makersmakingchange/LipSync-Wireless/README.md

## LipSync Wireless
**As of 2024-Feb-08, this version of the LipSync is now obsolete and has been replaced by the [LipSync 4](https://github.com/makersmakingchange/LipSync).**

<p align="center">
LipSync Logo
</p>

The LipSync is an assistive technology device that allows quadriplegics and other people with limited hand function to use touchscreen mobile devices, tablets, and computers by manipulation of a mouth-operated joystick with integrated sip and puff controls. This is an Open-Source Hardware project, so the Lipsync can be made at the community level for less than $300.

This GitHub repository will serve as a database for all files and documentation associated with the LipSync Wireless project.

WARNING - Unfortunately, as of 2021-Jul-21, the Bluetooth Module has been retired and is no longer for sale [Sparkfun Bluetooth Mate Silver](https://www.sparkfun.com/products/retired/12576). There is no suitable replacement component at this time. An updated design based on new hardware is under development ([LipSync X](https://github.com/makersmakingchange/LipSyncX)) but is not ready for release yet.

## Compatibility 

 <table style="width:100%">
  <tr>
    <th>Operating Systems</th>
    <th>Version</th>
    <th>Release</th>
    <th>Additional Information</th>
  <tr>
    <td>iOS</td>
    <td>13.1</td>
    <td>September 19,2019</td>
    <td>Compatible with iPhone 7 and newer versions</td>
  </tr>
  <tr>
    <td>Windows</td>
    <td>7-10</td>
    <td>2009</td>
    <td>Compatible with Windows 7 and newer versions (Requires Bluetooth 2.0 receiver)</td>
  </tr>
  <tr>
    <td>Android</td>
    <td>4+</td>
    <td>Released 2013</td>
    <td>Compatible with Android 4 and newer versions (Requires Bluetooth 2.0 receiver)</td>
  </tr>
  <tr>
    <td>MacOS</td>
    <td>10</td>
    <td>Released 2000</td>
    <td>Compatible with Mac OS X 10.0 and newer versions (Requires Bluetooth 2.0 receiver)</td>
  </tr>
  </table> 
  
## Getting Started
There are several options for obtaining a LipSync Wireless device.
1. Build it yourself
2. Request a volunteer maker to build one for you.

### 1. Build it Yourself
All the information you need to build a LipSync Wireless is avaiable in this repository. You'll need to order a number of off-the-shelf components, order a set of custom printed circuit boards and 3D print a number of components.

### 2. Volunteer Build
You can submit a build request through the Makers Making Change Website. A volunteer maker will build a LipSync and the requestor is responsible for the cost of materials and any shipping.

First, you'll need to [sign up](https://www.makersmakingchange.com/sign-up/) to create an account. Once your account is activated, you can log in.

Second, [submit a build request](https://makersmakingchange.com/request-a-build?project_id=3905) for a LipSync.

Once a volunteer maker agrees to take on your request, communicate with them to discuss details and reimbursement.

## Download

 <table style="width:100%">
  <tr>
    <th>Resource</th>
    <th>Version</th>
    <th>Format</th>
    <th>Link</th>
  </tr>
  <tr>
    <td>LipSync Wireless All</td>
    <td>3.0</td>
    <td>ZIP</td>
    <td><a href="https://github.com/makersmakingchange/LipSync-Wireless/archive/refs/heads/master.zip">LipSync-Wireless.zip</a></td>
  </tr>
  <tr>
    <td>LipSync Wireless Assembly Guide</td>
    <td>1.6</td>
    <td>PDF</td>
    <td><a href="https://github.com/makersmakingchange/LipSync-Wireless/blob/master/Documentation/LipSync_Assembly_Guide.pdf">LipSync_Assembly_Guide.pdf</a></td>
  </tr>
  <tr>
    <td>LipSync Wireless Startup Guide</td>
    <td>1.3</td>
    <td>PDF</td>
    <td><a href="https://github.com/makersmakingchange/LipSync-Wireless/blob/master/Documentation/LipSync_Wireless_Startup_Guide.pdf">LipSync_Wireless_Startup_Guide.pdf</a></td>
  </tr>
  <tr>
    <td>LipSync Wireless User Guide</td>
    <td>1.3</td>
    <td>PDF</td>
    <td><a href="https://github.com/makersmakingchange/LipSync-Wireless/blob/master/Documentation/LipSync_Wireless_User_Guide.pdf">LipSync_Wireless_User_Guide.pdf</a></td>
  </tr>
  <tr>
     <td>LipSync Wireless Mounting Guide</td>
     <td>1.0</td>
     <td>PDF</td>
     <td><a href="https://github.com/makersmakingchange/LipSync-Wireless/blob/master/Documentation/LipSync_Mounting_Guide.pdf">LipSync_Mounting_Guide.pdf</a></td>
  </tr>
  <tr>
    <td>LipSync Wireless BOM (XLSX)</td>
    <td>September 1, 2021</td>
    <td>XLSX</td>
    <td><a href="https://github.com/makersmakingchange/LipSync-Wireless/blob/master/Documentation/LipSync_Wireless_BOM.xlsx">LipSync_Wireless_BOM.xlsx</a></td>
  </tr>
  <tr>
    <td>LipSync Wireless BOM (CSV)</td>
    <td>September 1, 2021</td>
    <td>CSV</td>
    <td><a href="https://github.com/makersmakingchange/LipSync-Wireless/blob/master/Documentation/LipSync_Wireless_BOM.csv" download target="_blank">LipSync_Wireless_BOM.csv</a></td>
  </tr>
  <tr>
    <td>LipSync Wireless Firmware</td>
    <td>3.0</td>
    <td>INO</td>
    <td><a href="https://raw.githubusercontent.com/makersmakingchange/LipSync-Wireless/master/Software/LipSync_Wireless_Firmware/LipSync_Wireless_Firmware.ino">LipSync_Wireless_Firmware.ino</a></td>
  </tr>
  <tr>
    <td>Interface Board Layout</td>
    <td>2.71</td>
    <td>BRD</td>
    <td><a href="https://raw.githubusercontent.com/makersmakingchange/LipSync-Wireless/master/Hardware/PCB_design/Eagle/LipSync_Interface_Board/LipSync_Interface_Board.brd">LipSync_Interface_Board.brd</a></td>
  </tr>
  <tr>
    <td>Interface Board Schematic</td>
    <td>2.71</td>
    <td>SCH</td>
    <td><a href="https://raw.githubusercontent.com/makersmakingchange/LipSync-Wireless/master/Hardware/PCB_design/Eagle/LipSync_Interface_Board/LipSync_Interface_Board.sch">LipSync_Interface_Board.sch</a></td>
  </tr>
  <tr>
    <td>JLCPCB LipSync Interface Board Gerber</td>
    <td>2.71</td>
    <td>ZIP</td>
    <td><a href="https://github.com/makersmakingchange/LipSync-Wireless/raw/master/Hardware/PCB_design/Gerber/LipSync_Interface_Board/JLCPCB_LipSync_Interface_Board.zip">JLCPCB_LipSync_Interface_Board.zip</a></td>
  </tr>
  <tr>
    <td>OSHPark LipSync Interface Board Gerber</td>
    <td>2.71</td>
    <td>ZIP</td>
    <td><a href="https://github.com/makersmakingchange/LipSync-Wireless/raw/master/Hardware/PCB_design/Gerber/LipSync_Interface_Board/OSHPark_LipSync_Interface_Board.zip">OSHPark_LipSync_Interface_Board.zip</a></td>
  </tr>
  <tr>
    <td>PCBWay LipSync Interface Board Gerber</td>
    <td>2.71</td>
    <td>ZIP</td>
    <td><a href="https://github.com/makersmakingchange/LipSync-Wireless/raw/master/Hardware/PCB_design/Gerber/LipSync_Interface_Board/PCBWay_LipSync_Interface_Board.zip">PCBWay_LipSync_Interface_Board.zip</a></td>
  </tr>
  <tr>
    <td>Seeed Fusion LipSync Interface Board Gerber</td>
    <td>2.71</td>
    <td>ZIP</td>
    <td><a href="https://github.com/makersmakingchange/LipSync-Wireless/raw/master/Hardware/PCB_design/Gerber/LipSync_Interface_Board/Seeed_Fusion_LipSync_Interface_Board.zip">Seeed_Fusion_LipSync_Interface_Board.zip</a></td>
  </tr>	
  <tr>
    <td rowspan="9">Housing_design</td>
    <td rowspan="9">3.0</td>
    <td rowspan="9">STL</td>
    <td><a href="https://github.com/makersmakingchange/LipSync-Wireless/blob/master/Hardware/Housing_design/LipSync_Button.stl">LipSync_Button.STL</a></td>
  </tr>
  <tr>
  <td><a href="https://github.com/makersmakingchange/LipSync-Wireless/blob/master/Hardware/Housing_design/LipSync_Front_Housing.STL">LipSync_Front_Housing.STL</a></td>
  </tr>
  <tr>
	<td><a href="https://github.com/makersmakingchange/LipSync-Wireless/blob/master/Hardware/Housing_design/LipSync_Joystick_Base.STL">LipSync_Joystick_Base.STL</a></td>
</tr>
<tr>
  <td><a href="https://github.com/makersmakingchange/LipSync-Wireless/blob/master/Hardware/Housing_design/LipSync_Joystick_Front.STL">LipSync_Joystick_Front.STL</a></td>
</tr>
<tr>
  <td><a href="https://github.com/makersmakingchange/LipSync-Wireless/blob/master/Hardware/Housing_design/LipSync_Joystick_Rocker.STL">LipSync_Joystick_Rocker.STL</a></td>
</tr>
<tr>
    <td><a href="https://github.com/makersmakingchange/LipSync-Wireless/blob/master/Hardware/Housing_design/Optional/LipSync_Joystick_Jig.STL">LipSync_Joystick_Jig.STL</a></td>
</tr>
<tr>
  <td><a href="https://github.com/makersmakingchange/LipSync-Wireless/blob/master/Hardware/Housing_design/LipSync_Rear_Housing.STL">LipSync_Rear_Housing.STL</a></td>
</tr>
<tr>
  <td><a href="https://github.com/makersmakingchange/LipSync-Wireless/blob/master/Hardware/Housing_design/3D_Print_Settings.txt">Print_Settings.txt</a></td>
</tr>
</table> 

## Resources

<table style="width:100%">
  <tr>
    <th>Resource</th>
    <th>Link</th>
  </tr>
  <tr>
    <td>LipSync Firmware and Calibration Video</td>
    <td><a href="https://www.youtube.com/watch?v=RnpA24WH0Qk">Video</a></td>
  <tr>
    <td>LipSync Joystick Calibration Video</td>
    <td><a href="https://www.youtube.com/watch?v=Daf-54y6SBg">Video</a></td>
  </tr>
    <tr>
    <td>LipSync Build Video</td>
    <td><a href="https://www.youtube.com/watch?v=lBXpbkp5DW4&list=PLhoPg9bDvBR4CSFRfNbQ87ALnfaHOyM3C">Video</a></td>
  </tr>
</table> 

## License
<br>
<p align="center">
<a href="https://www.oshwa.org">
	Open Source Hardware Logo</a>
</p>

<p align="center">
This is an open source hardware project and adheres to the Open Source Hardware (OSHW) Statement of Principle 1.0 and Open Source Hardware (OSHW) Definition 1.0 found at <a href="http://www.oshwa.org">www.oshwa.org</a>
</p>

--

<!-- ABOUT MMC START -->
## About Makers Making Change
[Makers Making Change Logo](https://www.makersmakingchange.com/)

Makers Making Change is a program of [Neil Squire](https://www.neilsquire.ca/), a Canadian non-profit that uses technology, knowledge, and passion to empower people with disabilities.

Makers Making Change leverages the capacity of community based Makers, Disability Professionals and Volunteers to develop and deliver affordable Open Source Assistive Technologies.

 - Website: [www.MakersMakingChange.com](https://www.makersmakingchange.com/)
 - GitHub: [makersmakingchange](https://github.com/makersmakingchange)
 - Bluesky: [@makersmakingchange.bsky.social](https://bsky.app/profile/makersmakingchange.bsky.social)
 - Instagram: [@makersmakingchange](https://www.instagram.com/makersmakingchange)
 - Facebook: [makersmakechange](https://www.facebook.com/makersmakechange)
 - LinkedIn: [Neil Squire Society](https://www.linkedin.com/company/neil-squire-society/)
 - Thingiverse: [makersmakingchange](https://www.thingiverse.com/makersmakingchange/about)
 - Printables: [MakersMakingChange](https://www.printables.com/@MakersMakingChange)

### Contact Us
For technical questions, to get involved, or to share your experience we encourage you to [visit our website](https://www.makersmakingchange.com/) or [contact us](https://www.makersmakingchange.com/s/contact).
<!-- ABOUT MMC END -->
