makersmakingchange/LipSync-Wireless/Hardware/Housing_design/LipSync_Front_Housing.STL

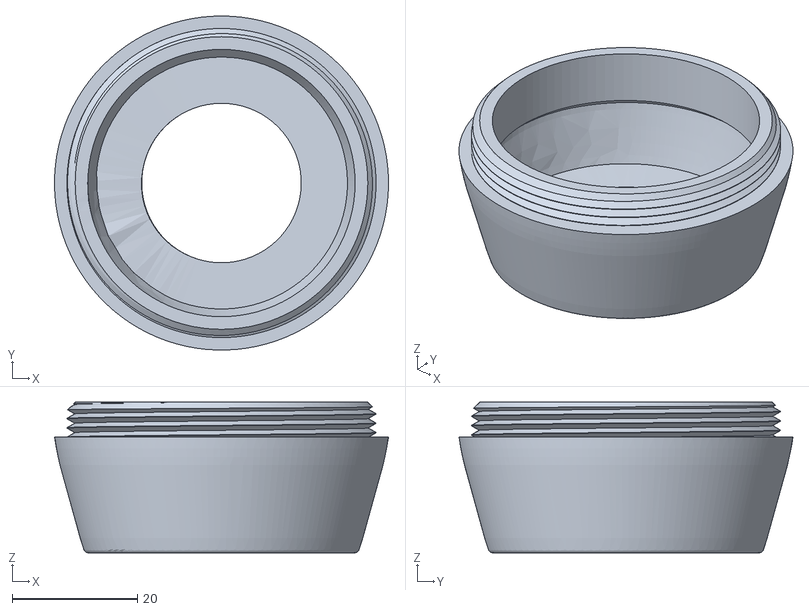
[picture p2: CAD file, 2022-07-18]
Hardware/Housing_design/LipSync_Front_Housing.STL
53.4 x 53.4 x 24.1
