makersmakingchange/LipSync-Wireless/Hardware/Housing_design/LipSync_Rear_Housing.stl

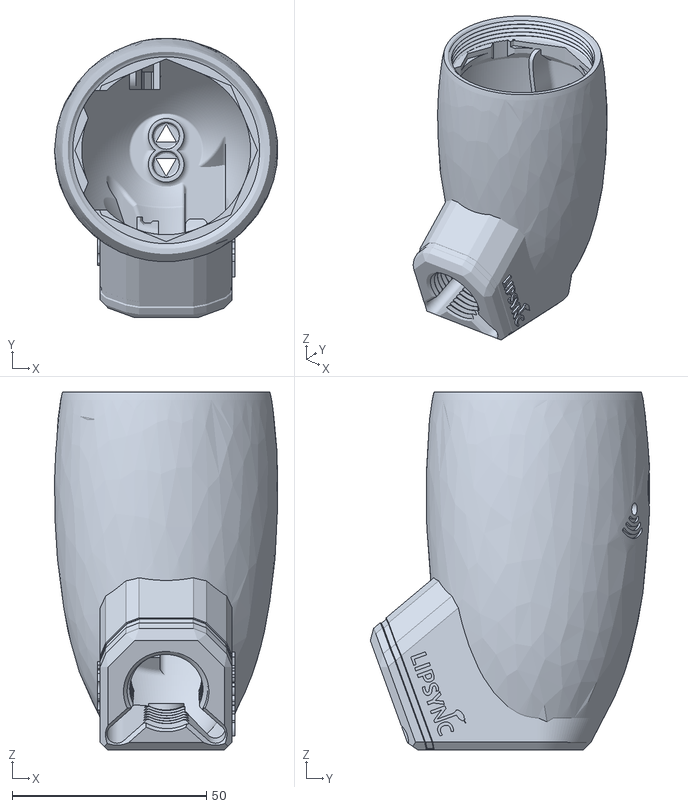
[picture p4: CAD file, 2022-07-18]
Hardware/Housing_design/LipSync_Rear_Housing.stl
57.5 x 72.0 x 92.2
