makersmakingchange/LipSync-Wireless/Hardware/Housing_design/LipSync_Button.stl

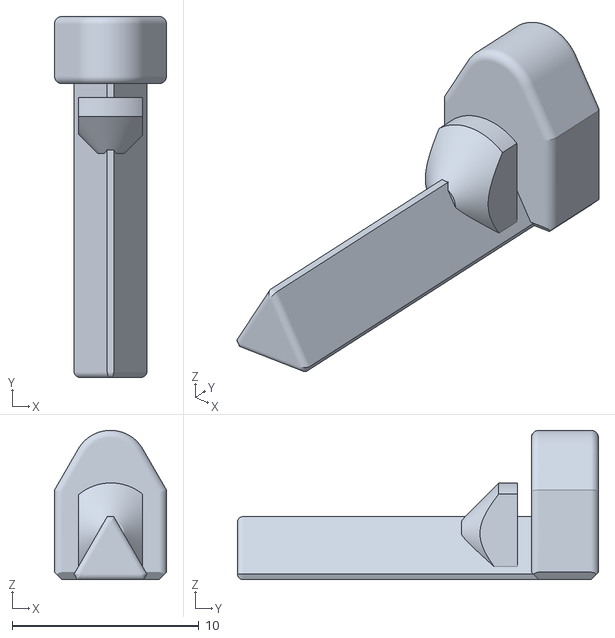
[picture p5: CAD file, 2019-10-01]
Hardware/Housing_design/LipSync_Button.stl
6.00 x 19.3 x 8.00
