makersmakingchange/LipSync-Wireless/Hardware/Housing_design/LipSync_Joystick_Front.STL

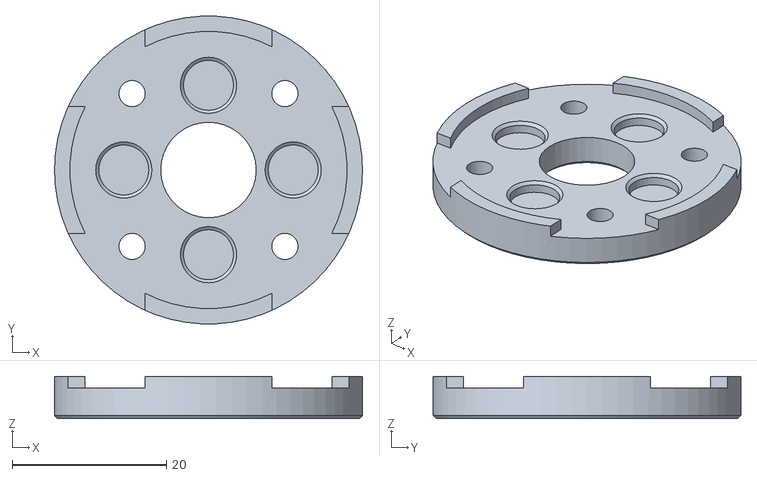
[picture p6: CAD file, 2019-09-17]
Hardware/Housing_design/LipSync_Joystick_Front.STL
40.0 x 39.9 x 5.50
