makersmakingchange/LipSync-Wireless/Hardware/Housing_design/LipSync_Joystick_Rocker.STL

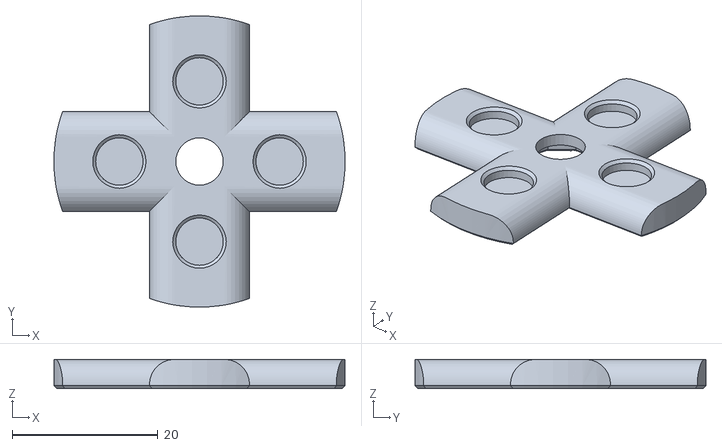
[picture p8: CAD file, 2019-09-17]
Hardware/Housing_design/LipSync_Joystick_Rocker.STL
40.0 x 40.0 x 4.00
