makersmakingchange/LipSync-Wireless/Documentation/LipSync_Mounting_Guide.pdf

# MOUNTING THE LIPSYNC

## By: Manal Faour

## Contents

Introduction The LipSync is a mouth operated mouse replacement that allows people with severe mobility

impairments to use mobile devices such as a mobile phone. The lightness of the LipSync as well as its compactness make it a great candidate for portable, wheelchair mounted applications but some considerations need to be taken when choosing a mounting option to ensure ease of use and safety of the user. This document details the considerations of how to mount the LipSync. Now that you have the LipSync, how can you mount it onto a wheelchair? What options are there for your mobile device? What are some of the considerations to have in mind when choosing a mounting option?

## Mounting to a Wheelchair

## Mounting Points

Every wheelchair is different in terms of the points available for mounting. Below is a list of some common mounting points that are available on power wheelchairs. The sketches illustrate the locations of these mounting points on the wheelchair.
1. Headrest rail
2. Back of wheelchair
3. Armrest rail
4. Under chair cushion
5. Chair rail
6. Footplate

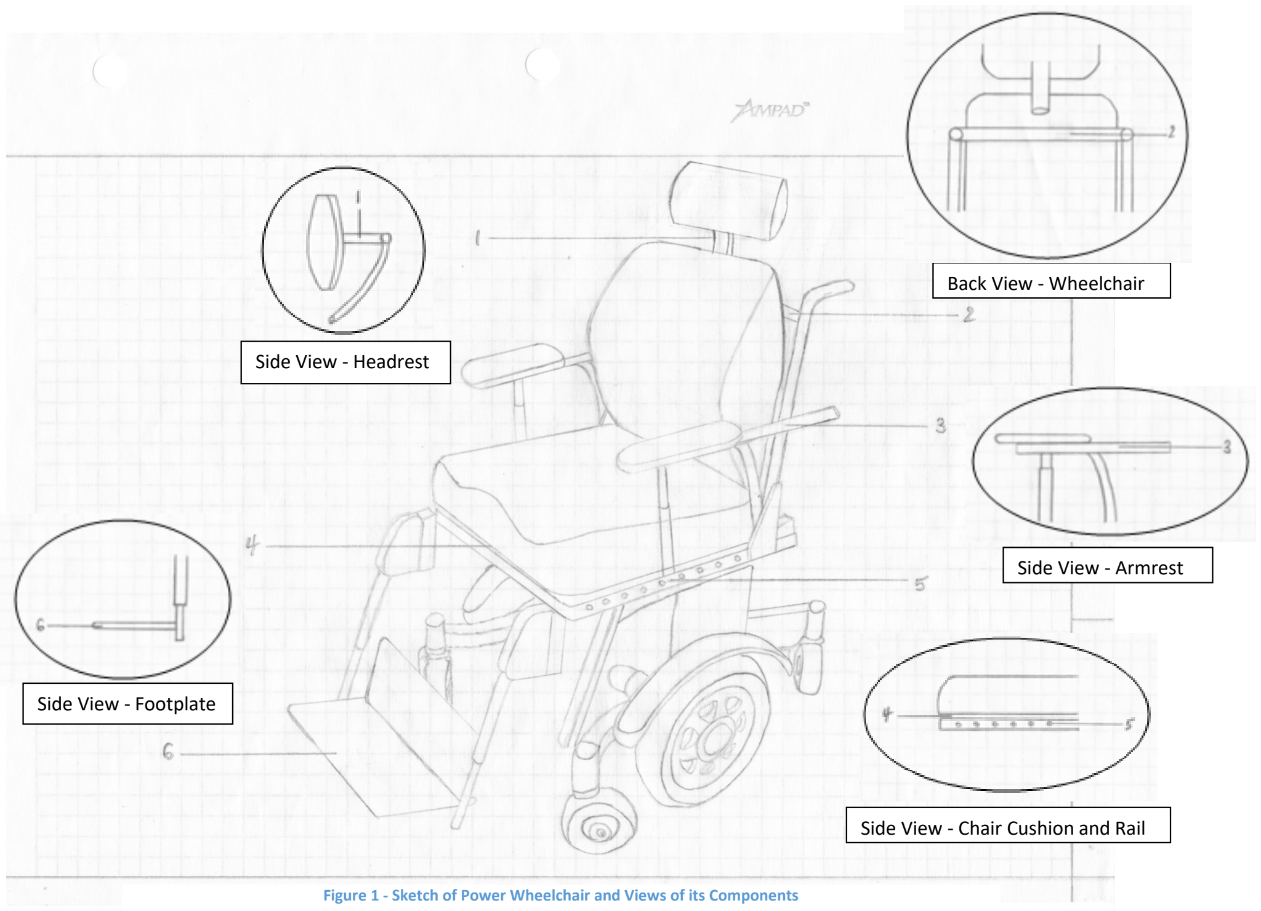
[picture p32: page 5]

Side View - Headrest

Side View - Armrest

Back View - Wheelchair

Side View - Chair Cushion and Rail

Side View - Footplate

Figure 1 - Sketch of Power Wheelchair and Views of its Components

## Considerations

When choosing a mount, many things need to be taken into consideration to ensure the safety of the user. Below you'll find a complete detailed list of these considerations. For a quick checklist, refer to Appendix A Checklist for After Choosing a Mount.
1. Mounting at the sides can make doorways difficult to navigate. Modern wheelchairs are 24"-27" in width and a wheelchair accessible door is usually 32" therefore care should be taken when mounting to the side of the wheelchair. Ensure that the addition of the mount at the sides of the wheelchair does not extend beyond the wheelchair frame to avoid hitting the doorway and potentially dislodging the mount, thereby putting the user at a safety risk. There is also a risk of the mount getting caught in obstacles. The image below demonstrates a setup that must be avoided as it can be easily snagged on something or could potentially bump into surrounding objects.

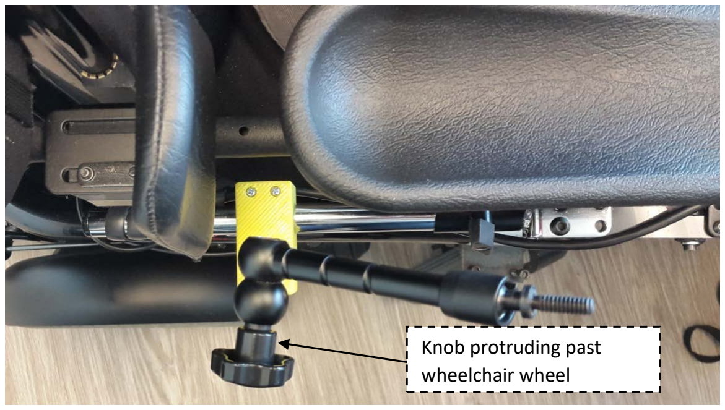
[picture p33: figure]
Knob protruding past wheelchair wheel

Figure 2 - Image of an Unacceptable Mount Setup
2. Attaching a clamp vertically may cause slipping of the mount. Therefore care must be taken when mounting in this direction.
3. To increase the friction and avoid slipping of a clamp additional anti skid pads may be added. A common product that is used for this purpose is Dycem, which provides reels of non-slip mats and tapes. Another option is "Magic Wrap" used for plumbing repairs.
4. Care should be taken when mounting to the headrest especially in reclining chairs. In a reclined position, the mount is more likely to detach and fall. Some solutions to this problem is increasing the friction of the mount using methods described above. Another solution is to choose a mount that completely encases the rail of the headrest as shown in the image below.

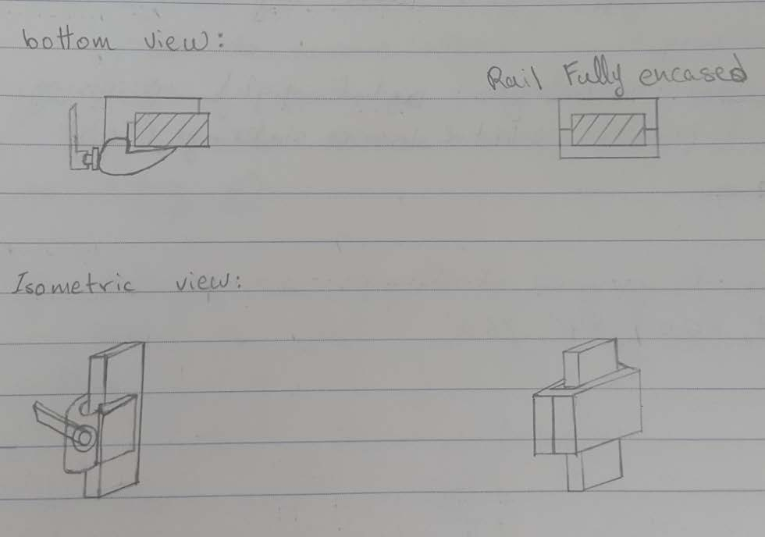
[picture p34: figure]

Figure 3 - A bottom and isometric view of a clamp that does not encase the rail vs. one that does
5. Wiring must be avoided to prevent faulty connections of the wheelchair devices.
6. Clearance around the wheels must be maintained to avoid detachment of the device or damage to the wheelchair.
7. In many wheelchairs, reclining causes a few components of the wheelchair to shift in position. Therefore, when choosing a mounting point check that there is clearance around the different components in both a reclined and non-reclined position.
8. When positioning the LipSync, care should be taken to ensure that the driving view of the user is not obstructed.
9. When positioning the LipSync, make sure that it is vertically aligned as described in Figure 4. Assemblies with goosenecks or ball and sockets at the top allow for positioning the LipSync vertically.

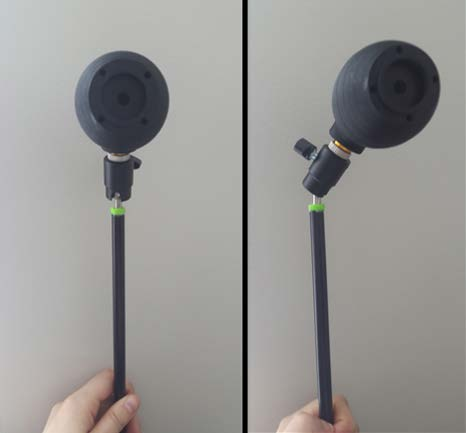
[picture p35: figure]

Figure 4 - Left: LipSync Positioned Vertically; Right: LipSync Positioned Non-vertically
10. When positioning the mobile device ensure that it is within viewing angle of the LipSync. The normal optical axis for a person in a sitting position is at 15° below eye level (Figure 4).
For example, if mounting a phone 35cm away from your face, the normal optical axis for a person in a sitting position is 15° below the 0° line, which translates to 7cm below eye level at that distance (Appendix D Field of Vision Claculations). The Limit of the range of vision is at 70-80°.

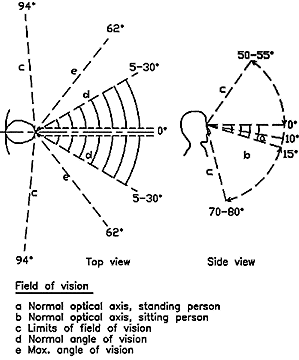
[picture p36: figure]

Figure 5 - Field of Vision Range ((SOLIDERE) & (ESCWA), 1994)
11. When positioning the mobile device, make sure that it is adjusted to avoid glare from the sun. In some cases, it may be necessary to add an anti-glare screen protector to the mobile device available here. (https://www.amazon.ca/Tech-Armor-Anti-Glare-Anti-Fingerprint-Protectors/dp/B00IGISQUO)
12. On some power wheelchairs, the armrest can be lifted to allow for transferring the wheelchair user. Therefore, mounting to that side of the wheelchair in those cases is not recommended.
13. Mounting at the back of the wheelchair requires the mount to be very long compared to other mounting points. In this position the mount experiences a large amount of torque which could cause it to fail.

Suppliers The following list is meant to serve as an introduction to suppliers that offer mounts that could be used

for the LipSync or a mobile device. The list is by no means exclusive since many other retailers sell mounts that work for our application either specific to assistive technology or not.

## On-Stage

https://on-stage.com/
On-Stage manufactures a range of stands for musical instruments and microphones. Advantages
a. It offers solutions at a lower price in comparison to the other suppliers.

Drawbacks
b. The goosenecks they offer are used for light weights and may sag under a heavy weight.
Sample Parts and Approximate Prices
Part No. | Description | Supplier | Qty | Approximate Cost (CAD)
MSA9030-19B | 19" Gooseneck, Black | Best Buy | 1 | $15
MSA9030-13B | 13" Gooseneck, Black | Best Buy | 1 | $10
MSA9030-06B | 6" Gooseneck, Black | Best Buy | 1 | $7
MSA9505 | Posi-Lock Telescoping Mini-Boom | Best Buy | 1 | $30

## Loc Line

http://www.loc-line.com/
Lockwood products inc manufactures Loc-Line - a range of adjustable plastic hoses and adaptors originally developed for cooling purposes in machine tool operations.
Advantages
a. Hand adjustable for both position and length.
b. Unique ball and socket design, bending does not decrease the inside diameter.
c. Can be twisted along its axis.
d. Easily washable and is resistant to most common chemicals.
e. Reasonably priced and is widely available.
f. Hollow so a wire can be fed through it.
g. Able to use for both the phone and the LipSync device using one setup (Y fitting). Drawbacks
a. Not suitable for applications where high loads are involved.
Sample Parts and Approximate Prices
* EH Pope is a Canadian distributor
Part No. | Description | Supplier | Qty | Approximate Cost (CAD)
Direct Mounting Solutions (to wheelchair)
510001 | Spring Clamp, 2", with integrated 3/4" ID Fixed Mount. Assembled. | Modular Hose | 1 | $9
512001 | Round Tube and Flat Surface Clamp Kit. | Modular Hose | 1 | $39
Extension Lines
61501 | Hose Segments Pack for 3/4" ID System. Includes (2) 5" long segments. Approximately 1 foot. | EH Pope | 1 | $7
51801 | Hose Segments Pack for 1/2" ID System. Includes (2) 5" long segments. Approximately 1 foot. | EH Pope | 1 | $6

## Ablenet

https://www.ablenetinc.com/technology/mounting-cases
Advantages
a. The mounts are all sold as a whole piece - no need to buy anything else.
b. Many available options from a gooseneck to mounting arms. Drawbacks
a. Relatively expensive.
Sample Parts and Approximate Prices
Part No. | Description | Supplier | Qty | Approximate Cost (CAD)
- | Latitude Mounting Arm (quick release) | Ablenet | 1 | $440
- | Gooseneck Mounting System | Ablenet | 1 | $250
- | Friction Knob Universal Mounting System | Ablenet | 1 | $325

## SnakeClamp

http://snakeclamp.com/Category/smartphone-snakeclamp-desk-stand-mount-holder-flexible-goosneck-arm (http://snakeclamp.com/Category/smartphone-snakeclamp-desk-stand-mount-holder-flexible-goosneck-arm)
Advantages
a. You have the option of building your own mount.
b. Heavy duty goosenecks are available.
Drawbacks
a. Goosenecks may be unstable and sag under heavy weight.
Sample Parts and Approximate Prices
Part No. | Description | Supplier | Qty | Approximate Cost (CAD)
Direct Mounting Solutions (to wheelchair)
SCP-MC | Multiclamp | SnakeClamp | 1 | $39
Extension Lines
SCP-GN24 | 24" Heavy Duty Flexible Gooseneck Arm | SnakeClamp | 1 | $39
SCP-GN18 | 18" Flexible Gooseneck Arm | SnakeClamp | 1 | $22
SCP-GN18HD | 18" Heavy-Duty Flexible Gooseneck Arm | SnakeClamp | 1 | $24
SCP-GN13B | 13" Flexible Gooseneck Arm, Black | SnakeClamp | 1 | $22
SCP-GN09 | 9" Flexible Gooseneck Arm | SnakeClamp | 1 | $14
SCP-RA12 | 12" Rigid Arm | SnakeClamp | 1 | $18

## Manfrotto

https://www.manfrotto.ca/
Manfrotto manufactures a range of clamps, adaptors and fixtures for mounting cameras, lighting devices and studio accessories.
Advantages
a. Load carrying capacity is relatively high.
Drawbacks
a. Cost is relatively high.
b. Electrically conductive.
c. Heavy, bulky and has a very 'industrial' appearance. Sample Parts and Approximate Prices
Part No. | Description | Load
capacity
(kg)

Max length
(mm)
Supplier | Qty | Approximate
Price (CAD)
Direct Mounting Solutions (to wheelchair)
171 | Mini clamp | 1 | - | Manfrotto | 1 | $40
035 | Super Clamp | 15 | - | Manfrotto | 1 | $57
635 | Quick Action Super Clamp | 15 | - | Manfrotto | 1 | $70
Extension Lines
244N | Variable friction arm | 3 | 530 | Manfrotto | 1 | $200
237 | Flex arm. ID 13mm. | 0.3 | 550 | Manfrotto | 1 | $50
237 HD | Heavy duty flex arm. ID 18mm. | 0.5 | 550 | Manfrotto | 1 | $60
196AB-2 | Single articulated arm: 2 sections | 1.5 | 605 | Manfrotto | 1 | $55

## LinkDelight

http://linkdelight.com/en/.html
LinkDelight offers a range of photography equipment. Advantages
a. Offers compact and small mounts.
Drawbacks
a. Mainly aimed at the photography industry therefore some adapters need to be purchased. Sample Parts and Approximate Prices
Part No. | Description | Supplier | Qty | Approximate Cost (CAD)
| 11" Magic Adjustable Arm for Lilliput Monitor / | Amazon | 1 | $15

LED Light Video Monitor
11" Articulating Magic Arm + Small Clamp Crab Pliers + Gopro Adapter+ Stainless Steel Thumber Screw Accessory Kit | LinkDelight | 1 | $24
Digital Camera Camcorder Mini Ballhead 1/4" Screw Thread Base | LinkDelight | 1 | $6
Mini Ball Head with Lock and Hot Shoe Adapter Camera | Amazon | 1 | $5

## Mobility Mount

http://www.mobilitymount.com/
Mobility Mount provides mounts specifically for wheelchair users. It's uniqueness lies in the fact that the base of the mount is held under the seat cushion. Many adapters are available to allow for mounting multiple devices.
Advantages
a. Mount sits under chair cushion therefore no mounting points necessary.
Disadvantages
a. Expensive to buy.
Sample Parts and Approximate Prices
Part No. | Description | Supplier | Qty | Approximate Cost (CAD)
MM01 | Base with tube | Mobility Mount | 1 | $320
MT | Multi Table 10X14 with no slip | Mobility Mount | 1 | $155
TC | Tablet Configuration for table | Mobility Mount | 1 | $115

Mounting Assemblies Below you'll find some wheelchair mounting options for the LipSync, a mobile device, or the

combination of both. Endless setups may be assembled to fit a the user's needs. Some setups may be more convenient than others depending on the considerations listed in the previous sections. Some of these components can be purchased from other suppliers.

## LipSync

The LipSync has a standard 5/8"-27 thread female connection. The mounting options below include a 5/8"-27 thread male connection in order to connect to the LipSync.

### Mounting Options Per Price Range

$0 - $49
Most of the options below include a 3D printed clamp which contributes to the reduced price. The downside of using 3D printed parts is the reduction in the strength of the component and the likelihood of it breaking if used to hold up a heavy weight.
For the assembly instructions of the 3D Printed Clamp refer to Appendix B Assembly Instructions for 3D Printed Clamp.
For assembly instruction of the DIY Mount refer to Appendix C Assembly Instructions for DIY Mount. Note: There are two possible assemblies for the DIY Mount. A Mini Ball Head with Lock may be used in cases where the articulating arm and the arrow shafts do not provide enough flexibility to position the LipSync vertically. Steps for both options are included below.
Part No. | Description | Qty | Supplier | Approximate Cost (CAD)

Total
Option 1 - DIY Mount
3D Printed Clamp + Nuts and Bolts | 1 | - | $3 | $3
Female 1/4"-20 to 5/8"-27 Male 2 Piece Mic Adapter | 1 | Amazon | $9 | $9
11" Inch Friction Articulating Magic Arm for Camera DSLR | 1 | Amazon | $14 | $14
3D Printed 1/4-20 threaded insert | 1 | - | $0 | $0
Arrow shaft | 1 | Local Archery Store/Walmart | $7 | $7
3D printed Disk Gear + Nut and Bolt | 1 | - | $2 | $2
3D Printed 3/8-16 threaded holder | 1 | - | $0 | $0
For the second possible assembly
Mini Ball Head with Lock and Hot Shoe Adapter Camera | 1 | Amazon | $5 | $5
1/4 male to 3/8 male adapter | 1 | Amazon | $7 | $7
3/8 female to 5/8 male adapter | 1 | Amazon | $7 | $7
| | | TOTAL | $35 (Or $54)

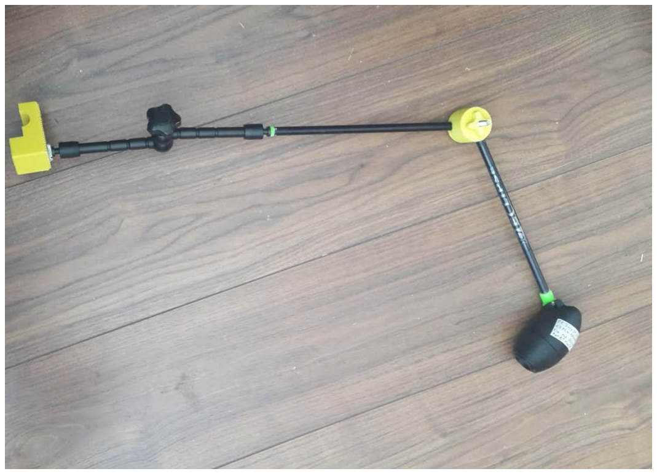
[picture p37: figure]

Figure 6 - From Left to Right: 3D Printed Clamp, Adapter, Articulating Arm, 3D Printed Adapter, Arrow Shaft, Disk Gear & Hand Knob, Arrow Shaft, 3D Printed Adapter, LipSync
Option 2
3D Printed Clamp + Nuts and Bolts | 1 | - | $3 | $3 1/4" Male To 3/8" Male Thread
| Adapter | 1 | Amazon | $7 | $7
| 3/8" Female to 5/8" Male thread adapter | 1 | Amazon | $7 | $7
MSA9030-19B | 19" Gooseneck, Black | 1 | Best Buy | $15 | $15
MSA9030-13B | 13" Gooseneck, Black | 1 | Best Buy | $10 | $10
| | | | TOTAL | $43

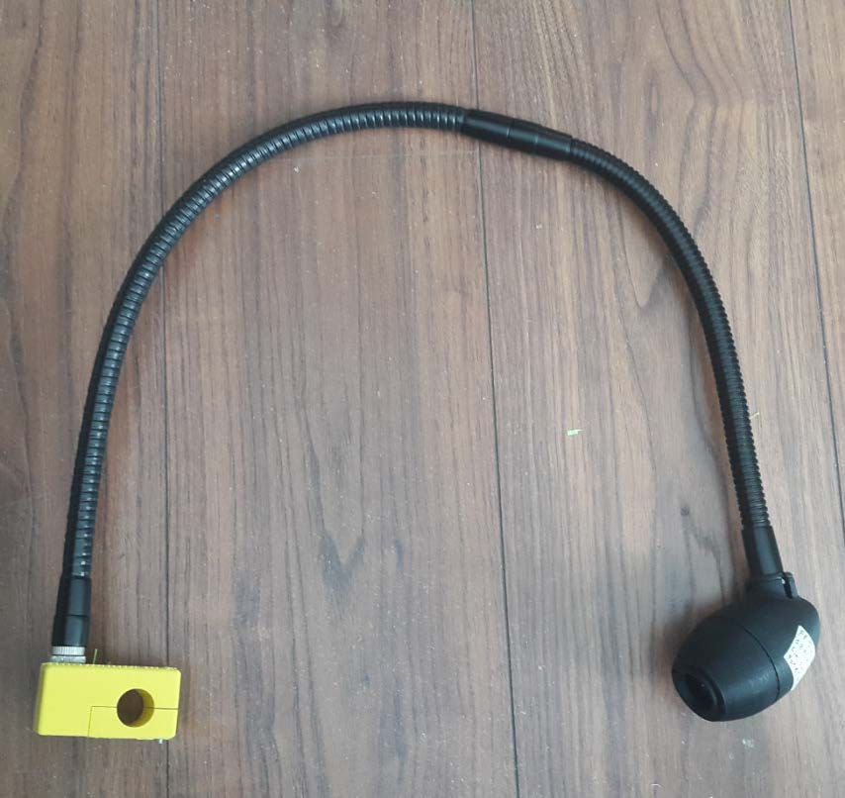
[picture p38: figure]

Figure 7 - From Left to Right: 3D Printed Clamp, Adapters, 19" Gooseneck, 13" Gooseneck, LipSync
Option 3
11" Articulating Magic Arm + Small Clamp Crab Pliers + Gopro Adapter+ Stainless Steel Thumber Screw Accessory Kit | 1 | Link Delight | $24 | $24
Female 1/4"-20 to 5/8"-27 Male 2 Piece Mic Adapter | 1 | Amazon | $9 | $9
19" Gooseneck, Black | 1 | Best Buy | $15 | $15
| | | TOTAL | $48
$50-$99
The options below increase in price due to the use of a commercial clamp (with the exception of option 2). The price is still otherwise competitive compared to other options due to the fact that the parts used are not necessarily meant for assistive technology applications. For instance as mentioned in the previous section (Suppliers), Loc Line was originally developed for cooling purposes for machine tool operations.
Part No. | Description | Qty | Supplier | Approximate Cost (CAD)

Total
Option 1
| Clamp with standard stud | 1 | Amazon | $28 | $28
MSA9030-19B | 19" Gooseneck, Black | 1 | Best Buy | $15 | $15
MSA9030-13B | 13" Gooseneck, Black | 1 | Best Buy | $10 | $10
| | | | TOTAL | $53

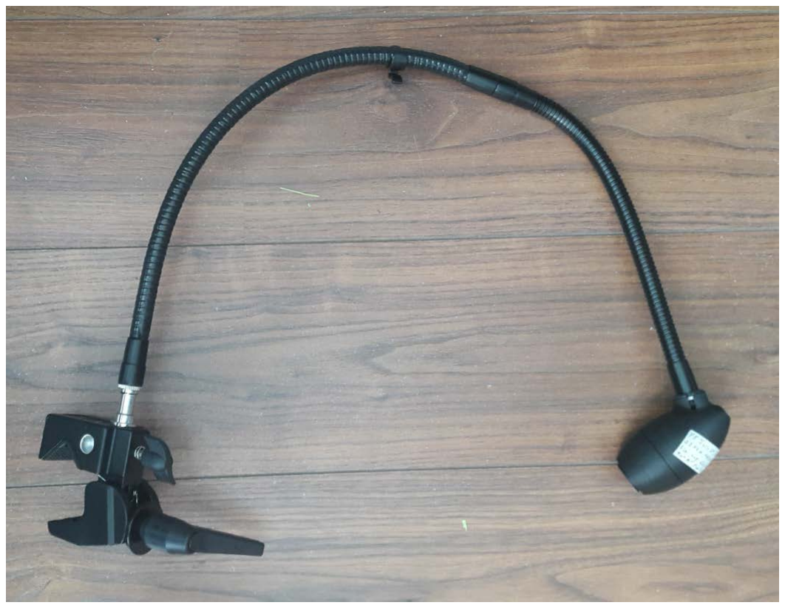
[picture p39: figure]

Figure 8 - From left to right: Super Clamp, Standard Stud, 19" Gooseneck, 13" Gooseneck, LipSync
Option 2
| 3D Printed Clamp+Nuts and Bolts | 1 | - | $3 | $3
| 1/4" Male To 3/8" Male Thread Adapter | 1 | Amazon | $7 | $7
| 3/8" Female to 5/8" Male thread adapter | 1 | Amazon | $7 | $7
MSA9505 | Posi-Lock Telescoping Mini-Boom | 1 | Amazon | $30 | $30
MSA9030-19B | 6" Gooseneck, Black | 1 | Best Buy | $7 | $7
| | | | TOTAL | $54

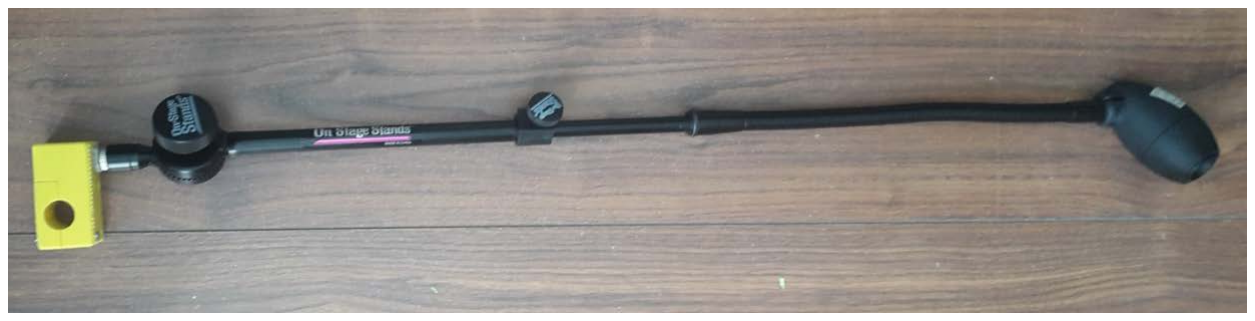
[picture p40: figure]

Figure 9 - From Left to Right: 3D Printed Clamp, Adapters, Posi-Lock Telescoping Mini-Boom, 13" Gooseneck, LipSync

Option 3
512001 | Round Tube and Flat Surface Clamp Kit. (see above) | 1 | Modular Hose | $39 | $39
61501 | Loc-Line Hose Segments Pack for 3/4" ID System. Includes (2) 5 3/4" segments. Approximately 1 foot. (see above) | 1 | EH Pope | $7 | $7
51801 | 1/2" Hose, one foot, in Black (51801-BLK) -1/2" Black Loc-Line | 1 | EH Pope | $6 | $6
61508 | 3/4" to 1/2" Adapter in Black (61508-BLK) -Black Hose | 1 | EH Pope | $3 | $3
51805 | 1/2" NPT Connector in Black (51805-BLK) -1/2" Black Loc-Line | 1 | EH Pope | $1 | $1
| | | | TOTAL | $56

Option 4
| Clamp with standard stud | 1 | | $28 | $28
MSA9505 | Posi-Lock Telescoping Mini-Boom | 1 | Amazon | $29 | $29
MSA9030-19B | 13" Gooseneck, Black | 1 | Best Buy | $10 | $10
| | | | TOTAL | $67

$100+
These assemblies are used in industries such as the assistive technology industry or the photography industry. Their robustness, weight capacity and industrial use drive their prices up.
Part No. | Description | Qty | Supplier | Approximate Cost (CAD)

Total
Option 1
035 | Super Clamp | 1 | Manfrot to | $57 | $57
237 HD | Heavy duty flex arm. ID 18mm. | 1 | Manfrot to | $50 | $50
| Female 1/4"-20 to 5/8"-27 Female Adapter | 1 | Amazon | $9 | $9
| | | | TOTAL | $116

Option 2
| Clamp with standard stud | 1 | Amazon | $28 | $28
244N | Variable friction arm | 1 | Manfrot to | $210 | $200
| 1/4" To 3/8" Thread Adapter | 1 | Amazon | $9 | $9
| 5/8" Male to 3/8" Female Microphone Mic Stand Adapter | 1 | Amazon | $3 | $3
| | | | TOTAL | $240

## Mobile Device

No Mount
In many cases, the mobile device may be placed on the users lap, the lap tray mounted on their wheelchair, or on a table in front of the user. In this case there is no need for a mount. A stand may be used to adjust the viewing angle of the phone.
Mount
Phone mounts have a standard 1/4"-20 female thread. Therefore any mobile device holder may be selected in combination with the LipSync mounting options listed in the previous section (LipSync). The changes that need to be made relate to adding an adapter with a 1/4"-20 male thread. One potential option for a phone mount assembly is listed in the table below.
Part No. | Description | Qty | Supplier | Approximate Cost (CAD) | Total
| Mudder Universal Smartphone Holder Mount Adapter for Monopod Tripod Selfie Stick with Double Screw Head, Black | 1 | Amazon | $13 | $13
| Thread Adapter Microphone Stand 5/8"-27 Female to 1/4"-20 Male for Camera Monitor | 1 | Amazon | $9 | $9
MSA9030-19B | 19" Gooseneck, Black | 1 | Best Buy | $15 | $15
| Clamp with standard stud | 1 | Amazon | $28 | $28
| | | | TOTAL | $65

Combining LipSync and Mobile Device
There are some options to combine both the LipSync and a mobile device into one mount assembly setup. The idea of combining the LipSync and a mobile device simplifies the mount assembly process since it requires choosing only one mounting point. Combining the two systems also allows for a reduction in price since only one clamp is used. Two possible combinations were assessed and will be detailed below.
The first option includes the Loc Line hoses. Since a Y fitting is available, a system using these hoses can be formed to attach both a mobile device and the LipSync. The table below provides a complete assembly.
Part No. | Description | Qty | Supplier | Approximate Cost (CAD) | Total
512001 | Round Tube and Flat Surface Clamp Kit. | 1 | Modular Hose | $39 | $39
61501 | Loc-Line Hose Segments Pack for 3/4" ID System. Includes (2) 5 3/4" segments. Approximately 1 foot. (see above) | 2 | EH Pope | $7 | $14
51801 | 1/2" Hose, one foot, in Black (51801-BLK) -1/2" Black Loc-Line | 1 | EH Pope | $6 | $6
61511 | Loc-Line Y Fitting for 3/4" ID System. | 2 | EH Pope | $4 | $4
61508 | 3/4" to 1/2" Adapter in Black (61508-BLK) -Black Hose | 1 | EH Pope | $3 | $3

570009 | Extra deep V-tabs for tabX tablet holder. | 1 | Modular Hose | $24 | $24
51805 | 1/2" NPT Connector in Black (51805-BLK) -1/2" Black Loc-Line | 1 | EH Pope | $1 | $1
| | | | TOTAL | $91

The second option was developed for using goosenecks. This option includes a 3D printed bracket with 2 holes for the goosenecks. The image below shows the bracket holding 1 gooseneck. The other hole is meant to support another gooseneck

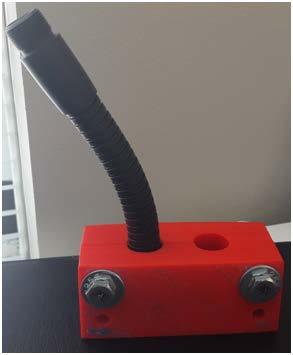
[picture p41: figure]

Figure 10 - 3D Printed Bracket Holding a Gooseneck
Part No. | Description | Qty | Supplier | Approximate Cost (CAD) | Total
| Clamp with standard stud | 1 | Amazon | $28 | $28
| 3D printed bracket | 1 | | $3 | $3
MSA9030-19B | 19" Gooseneck, Black 13" Gooseneck, Black | 2 1 | Best Buy Best Buy | $15 $10 | $30 MSA9030-13B $10 TOTAL $71

## Suggestions for Assembling Mounts

1. Tape some anti-skid pads like Dycem pads or "Magic Wrap" to increase the friction of the clamps and reduce their rotation about the tube.
2. If two assembly pieces are used, such as two goosenecks, glue them together at the attachment point to avoid separation or rotation.
3. Some of the problems associated with Loc-Line and goosenecks is the instability and their tendency to sag after continuous use. This could be solved using rescue tape, electrical tape or "Magic Wrap" wrapped around the pieces. Another solution is to add a stiff wire to the inside of the parts.
4. Goosenecks are a good option for small sections, but may become unstable as the length increases and may sag under their own weight. Therefore, it is not advisable to use goosenecks when the mounting point is further away from the user, such as the back of the wheelchair.
5. When using Loc Line, use the 3/4" tubes as the base to provide stability and stiffness to the setup. 1/2" tubes may be used at the top of the assembly.

### Appendix A Checklist for After Choosing a Mount

☐ Is the clamp secure and does not move?
☐ With the mount attached is there clearance around the wheels/wires/chair frame? ☐ Does the wheelchair fit through doorways?
☐ Is it possible for the mount to be snagged on obstructions as the user drives around? ☐ Is the driving view of the user clear with no obstructions?
☐ Is the mobile device within viewing angle of the LipSync?
☐ Can the user easily reach the LipSync to use it?

### Appendix B Assembly Instructions for 3D Printed Clamp

Tools:
1. Screwdriver
2. Glue
Components:
1. (4) 6-32x1" Round Head Machine Screws
2. (4) 6-32 Hex Machine Nuts
3. 3D Printed Clamp
4. 2" Piece of Magic Wrap
5. (1) Female 1/4"-20 to 5/8"-27 Male 2 Piece Mic Adapter
Steps:
1. Glue the 4 nuts in their assigned slots on the bottom piece of the clamp. Make sure not to add too much glue to avoid blocking the hole.

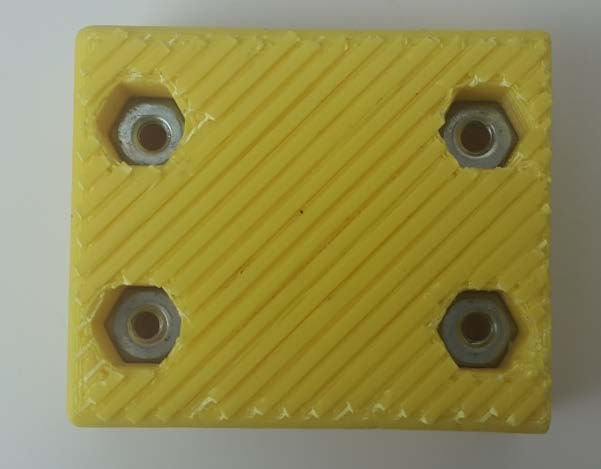
[picture p42: figure]

Figure 11 - Glued Nuts in Bottom Piece of Clamp
2. Glue the Female 1/4"-20 to 5/8"-27 Male 2 Piece Mic Adapter into the hole in the assembled 3D printed clamp as shown in the image below.

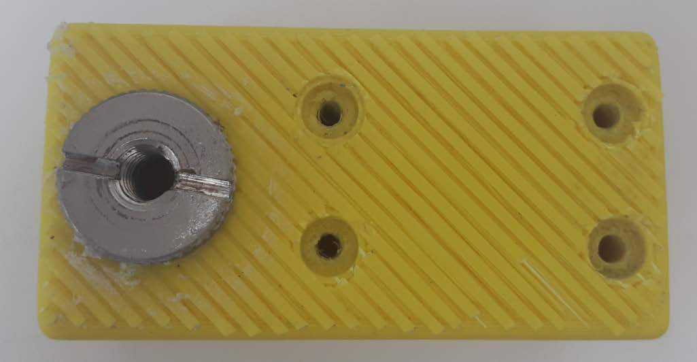
[picture p43: figure]

Figure 12 - Glued 1/4"-20 to 5/8"-27 Adapter in 3D Printed Clamp
3. Wrap the 2" piece of Magic Wrap around the section of the tube that you plan on mounting in to.

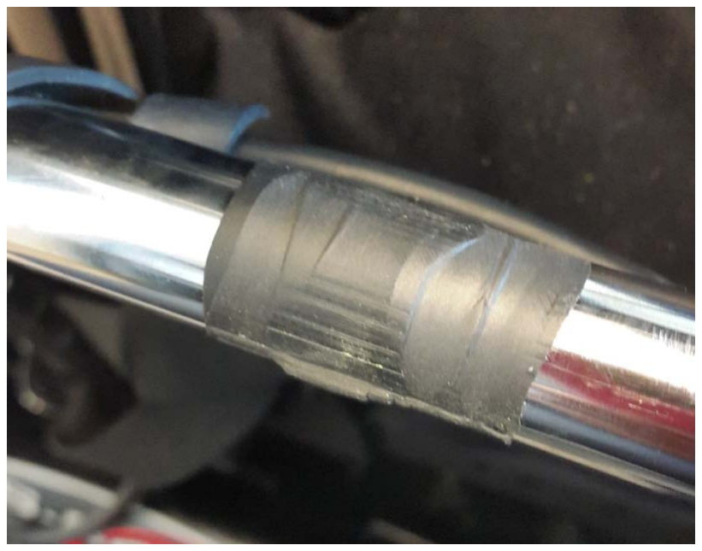
[picture p44: figure]

Figure 13 - Magic Wrap Around Wheelchair Tube
4. Place the bottom piece of the clamp on the Magic Wrap.
5. Align the top piece with the bottom piece and screw in the first bolt until it is secure. Repeat for the other 3 bolts.

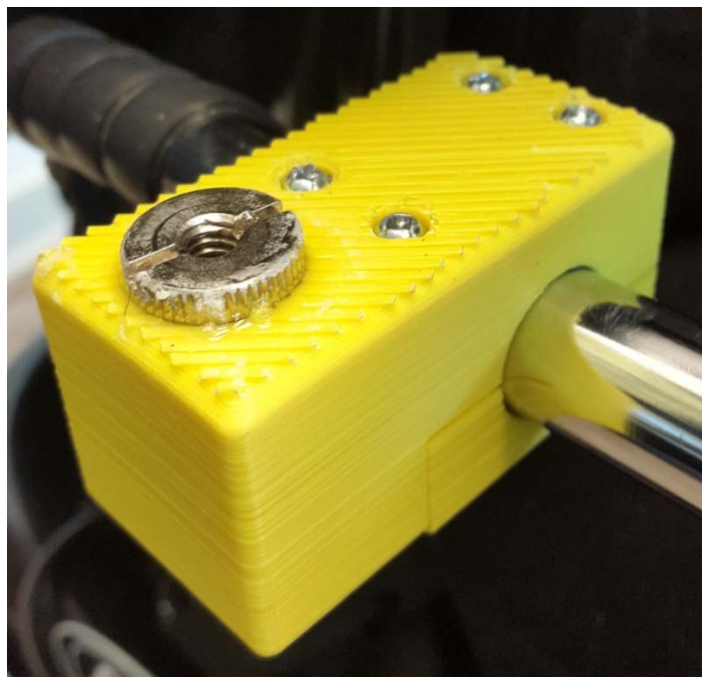
[picture p45: figure]

Figure 14 - Complete Assembly of Clamp

### Appendix C Assembly Instructions for DIY Mount

Tools:
1. Glue
2. Tube Cutter or Saw
Components:
1. (1) 5/16 in.-24 tpi x 1-1/2 in. Hex Cap Screw
2. (1) 5/16 in. Nut
3. 3D Printed Clamp
4. 3D Printed Disk Gear & Hand Knob
5. 3D Printed Threaded Adapters: 1/4-20 threaded insert & 3/8-16 threaded holder
6. 11" Inch Friction Articulating Magic Arm for Camera DSLR
7. Arrow Shaft - for the models provided we used an Easton Eclipse 2512 Arrow Shaft For the second possible assembly:
8. Mini Ball Head with Lock and Hot Shoe Adapter Camera (optional)
9. 1/4 male to 3/8 male adapter (optional)
10. 3/8 female to 5/8 male adapter (optiona)
Steps:
1. Assemble the 3D printed clamp as described in Appendix B Assembly Instructions for 3D Printed Clamp.

2. Screw the 11" Inch Friction Articulating Magic Arm for Camera DSLR into the Mic Adapter in the 3D printed clamp.
3. Determine the length of the arrow shaft necessary by adjusting the articulating arm and approximating the length necessary to reach the mouth of the user. There will be two sections of arrow shafts in total.
4. Use the tube cutter to cut the arrow shaft to size. Make sure to file the ends of the arrow shaft to remove sharp edges.
Note: we found that increasing the length of the arrow shaft increases the vibration of the whole assembly, which makes it difficult to use the LipSync. The maximum suggested length arrow shaft to use is 9".
5. Glue the 3D printed 3/8-16 threaded holder on one end of an arrow shaft.
6. Screw in the 5/8 to 3/8 threaded adapter in the LipSync. Make sure to leave room for the LipSync spacer or to place the spacer in its position.
7. Screw the 3/8-16 threaded holder into LipSync to help with aligning the Disk Gear. Be careful not to over-tighten as to avoid breaking the threaded holder.
8. Place the Disk Gear at the other end of the arrow shaft. Make sure that the side of the disk is aligned with the LipSync as shown in the image below. Glue the arrow shaft in the Disk Gear.

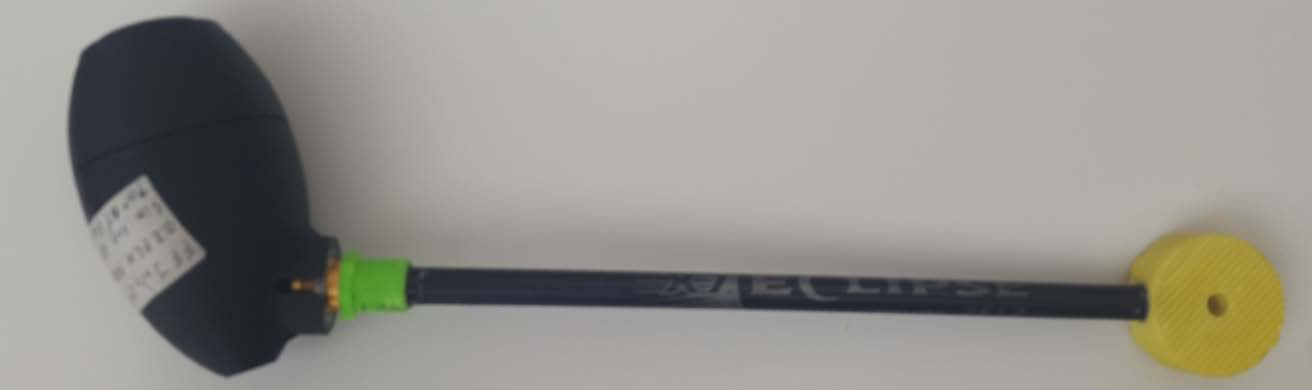
[picture p46: figure]

Figure 15 - Disk Gear Aligned with the LipSync

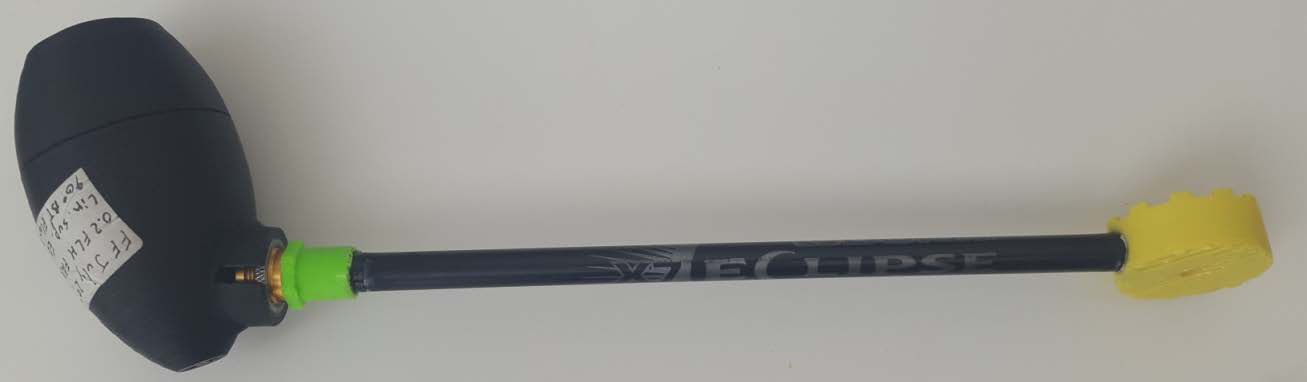
[picture p47: figure]

Figure 16 - Misaligned Disk Gear
9. Grab the other arrow shaft and glue the 3D printed 1/4-20 threaded insert.
10. Place the Disk Gear at the other end of the arrow shaft and glue it in place.
11. Place the Articulating Magic Arm onto the arrow shaft with the 1/4-20 threaded insert by threading it into the arrow shaft. It is advisable to glue the 1/4-20 insert to the Articulating Magic Arm to provide stability to the assembly.
12. Glue the 5/16 in nut int the 3D printed hand knob.

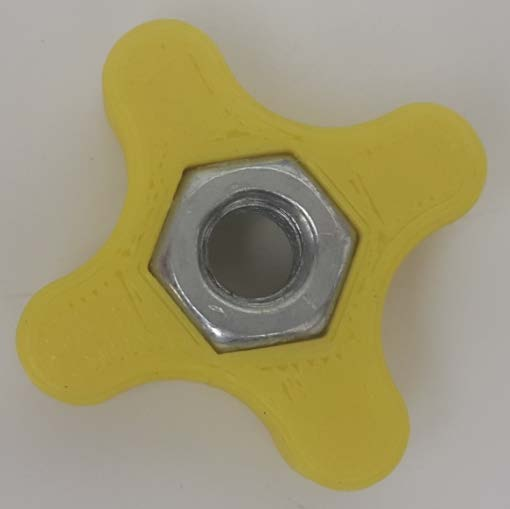
[picture p48: figure]

Figure 17 - Glued Nut in 3D Printed Hand Knob
13. Attach the second arrow shaft to the first by meshing the Disk Gear together. Use the 5/16 in.-24 tpi x 1-1/2 in. Hex Cap Screw and the Hand Knob to tighten the disk. You can glue in the Hex Cap Screw to keep it in place.

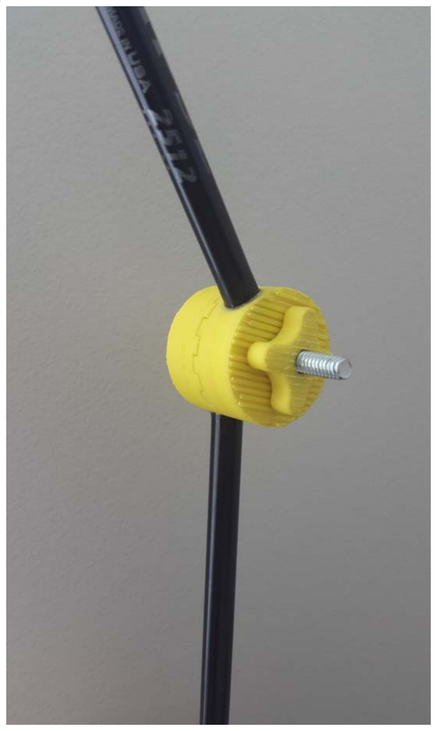
[picture p49: figure]

Figure 18 - Disk Gear Used to Adjust the Angle of the Arrow Shafts
14. Use both the Disk Gear and the Articulating Arm to adjust the angle of the LipSync.

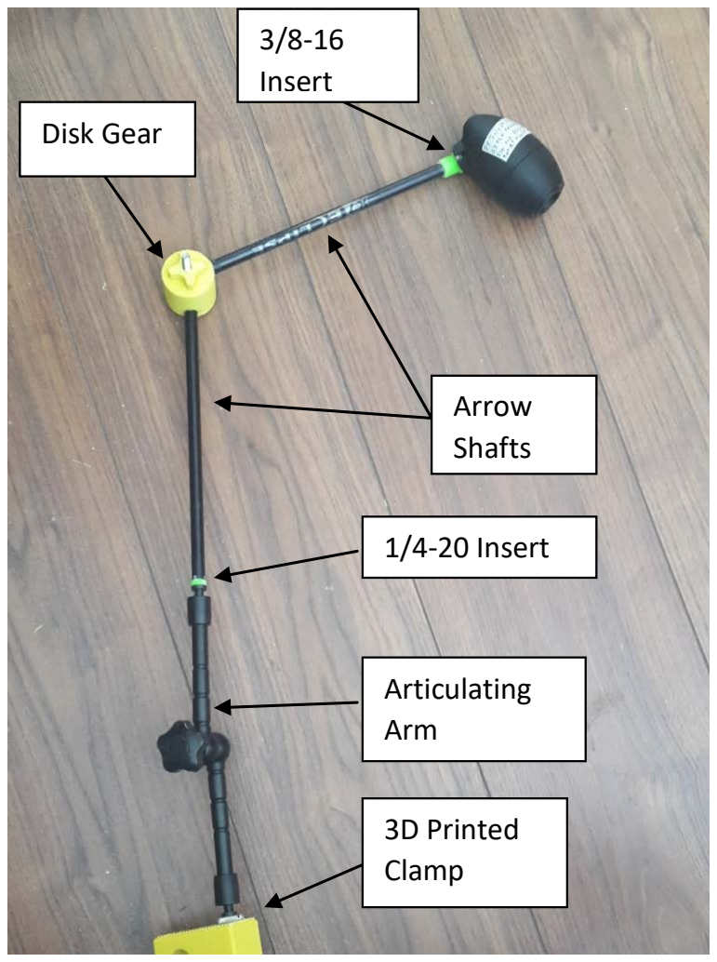
[picture p50: figure]
3D Printed Clamp; Articulating Arm; 1/4-20 Insert; Arrow Shafts; Disk Gear; 3/8-16 Insert

For the optional component:
15. Follow steps 1-4 outlined above.
16. Glue in the 3D printed 1/4-20 threaded insert on one end of an arrow shaft.
17. Glue in the bottom piece of the Disk Gear at the other end of the arrow shaft.
18. Grab the other arrow shaft and repeat step 2.
19. Glue the top piece of the Disk Gear at the other end of the arrow shaft.
20. Place the Mini Ball Head with Lock onto the other arrow shaft with the 1/4-20 threaded insert by threading it into the insert. It is advisable to glue the 1/4-20 insert to the Mini Ball Head with Lock to provide stability to the assembly.
21. Thread the 3/8 female to 5/8 male into the LipSync. Thread the 1/4 male to 3/8 male adapter into the adapter in the LipSync.
22. Thread the Mini Ball Head into the LipSync and adapter assembly.
23. Follow steps 12-13 outlined above.
24. Use the Disk Gear, Articulating Arm, and the Mini Ball Head to adjust the angle of the LipSync.

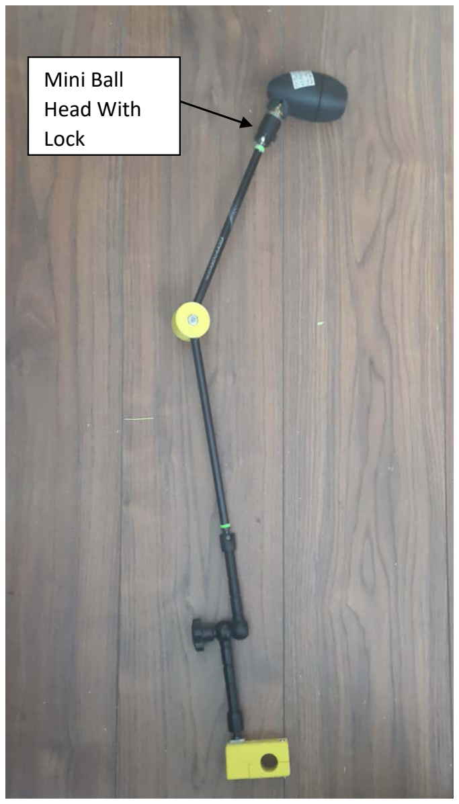
[picture p51: figure]
Mini Ball Head With Lock

Figure 19 - Complete Assembly of DIY Mount With Mini Ball Head

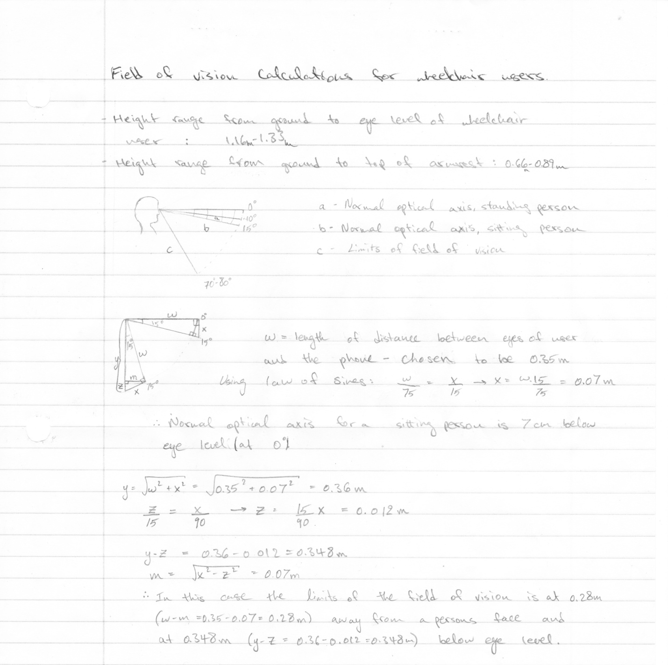
[picture p52: figure]

### Appendix D Field of Vision Claculations
