makersmakingchange/LipSync-Wireless/Hardware/PCB_design/Eagle/LipSync_Interface_Board/LipSync_Interface_Board.brd

## EAGLE design Hardware/PCB_design/Eagle/LipSync_Interface_Board/LipSync_Interface_Board.brd (2019-10-01)

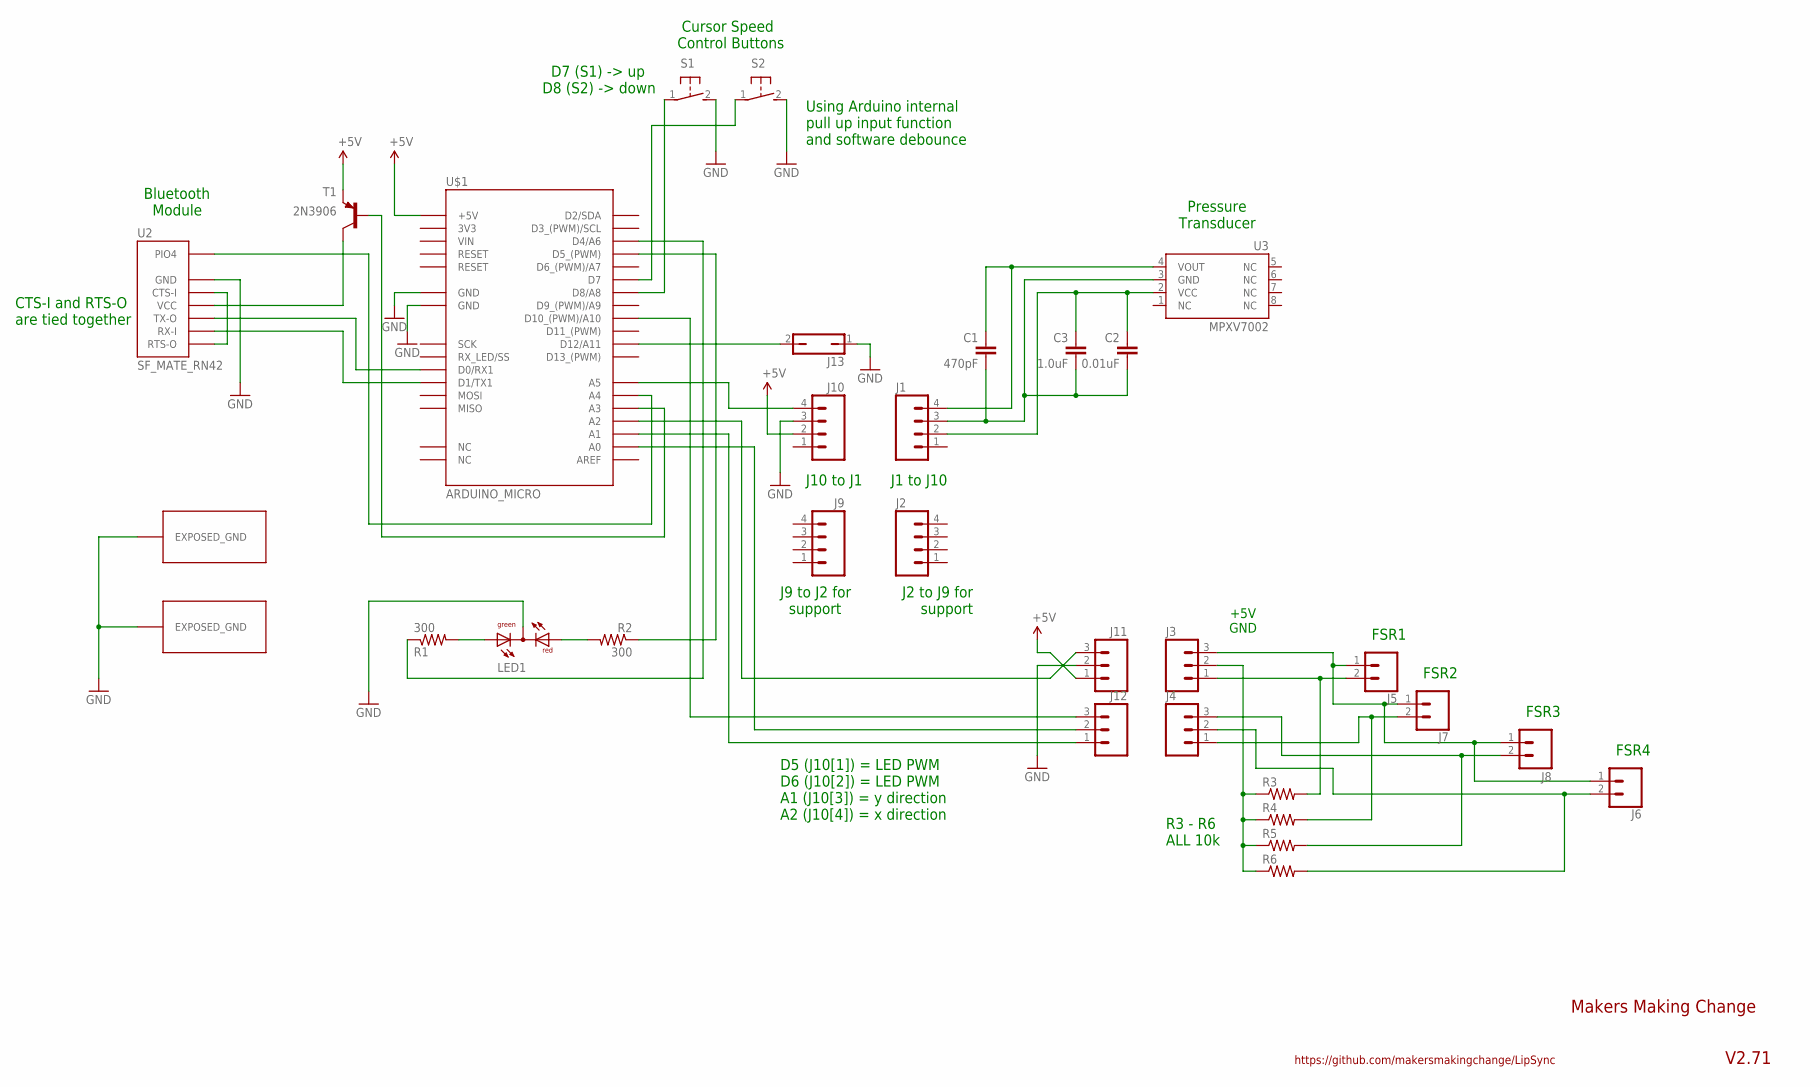
[picture p53: schematic LipSync_Interface_Board.sch]

Parts:
C1: 470pF; CAP-PTH-SMALLEZ
C2: 0.01uF; CAP-PTH-SMALLEZ
C3: 1.0uF; CAP-PTH-SMALLEZ
J1, J2, J9, J10: M04PTH; 1X04
J3, J4, J11, J12: M03LOCK; 1X03_LOCK
J5, J6, J7: CONN_02PTH3; 1X02_LONGPADS
J8: M02PTH3; 1X02_LONGPADS@1
J13: JP1Q; JP1
LED1: DUOLED-RG-C; DUOLED-C-5MM
R1, R2: 300; AXIAL-0.3
R3, R4, R5, R6: R-US_0204/5; 0204/5
S1, S2: 31-XXB3F-31XX-CUSTOM; B3F-31XX-CUSTOM
T1: 2N3906; TO92-EBC
U2: SF_MATE_RN42; BLUE_MATE_RN42_HEADER_FOOTPRINT
U3: MPXV7002; SOP8
U$1: ARDUINO_MICRO; ARDUINO_MICRO_HEADER_FOOTPRINT
U$2, U$3: EXPOSED_GND

Connections:
3V3: U$1.3V3
GND: J10.3, J11.2, J13.1, LED1.C, S1.2 (S), S2.2 (S), U2.GND, U$1.GND, U$1.GND@1 (GND), U$2.GND1, U$3.GND1
GND2: C1.2, C2.2, C3.2, J1.3, U3.3 (GND)
GND3: J3.2, R3.1, R4.1, R5.1, R6.1
unnamed: U2.PIO4, U$1.A4
unnamed: T1.C, U2.VCC
unnamed: U2.TX-O, U$1.RX1 (D0/RX1)
unnamed: U2.RX-I, U$1.TX1 (D1/TX1)
unnamed: J12.2, U$1.A0
unnamed: J12.1, U$1.A1
unnamed: C1.1, J1.4, U3.4 (VOUT)
unnamed: C2.1, C3.1, J1.2, U3.2 (VCC)
unnamed: U2.CTS-I, U2.RTS-O
unnamed: J12.3, U$1.D10 (D10_(PWM)/A10)
unnamed: J10.4, U$1.A5
unnamed: LED1.AX (AG), R1.P$2 (2)
unnamed: LED1.AR, R2.P$2 (2)
unnamed: S1.1, U$1.D8 (D8/A8)
unnamed: S2.1, U$1.D7
unnamed: J3.3, J5.1, J6.1, J7.1, J8.1
unnamed: R1.P$1 (1), U$1.D4 (D4/A6)
unnamed: R2.P$1 (1), U$1.D5 (D5_(PWM))
unnamed: T1.B, U$1.A3
unnamed: J11.3, U$1.A2
unnamed: J3.1, J5.2, R3.2
unnamed: J13.2, U$1.D12 (D12/A11)
unnamed: J4.1, J7.2, R4.2
unnamed: J4.3, J8.2, R5.2
unnamed: J4.2, J6.2, R6.2
VCC: J10.2, J11.1, T1.E, U$1.5V (+5V)

Notes on the sheet:
J9 to J2 for support
J2 to J9 for support
D5 (J10[1]) = LED PWM D6 (J10[2]) = LED PWM A1 (J10[3]) = y direction A2 (J10[4]) = x direction
CTS-I and RTS-O are tied together
J1 to J10
J10 to J1
Cursor Speed Control Buttons
D7 (S1) -> up D8 (S2) -> down
+5V GND
Bluetooth Module
Pressure Transducer
Using Arduino internal pull up input function and software debounce
R3 - R6 ALL 10k
FSR1
FSR2
FSR3
FSR4
Makers Making Change
V2.71
https://github.com/makersmakingchange/LipSync

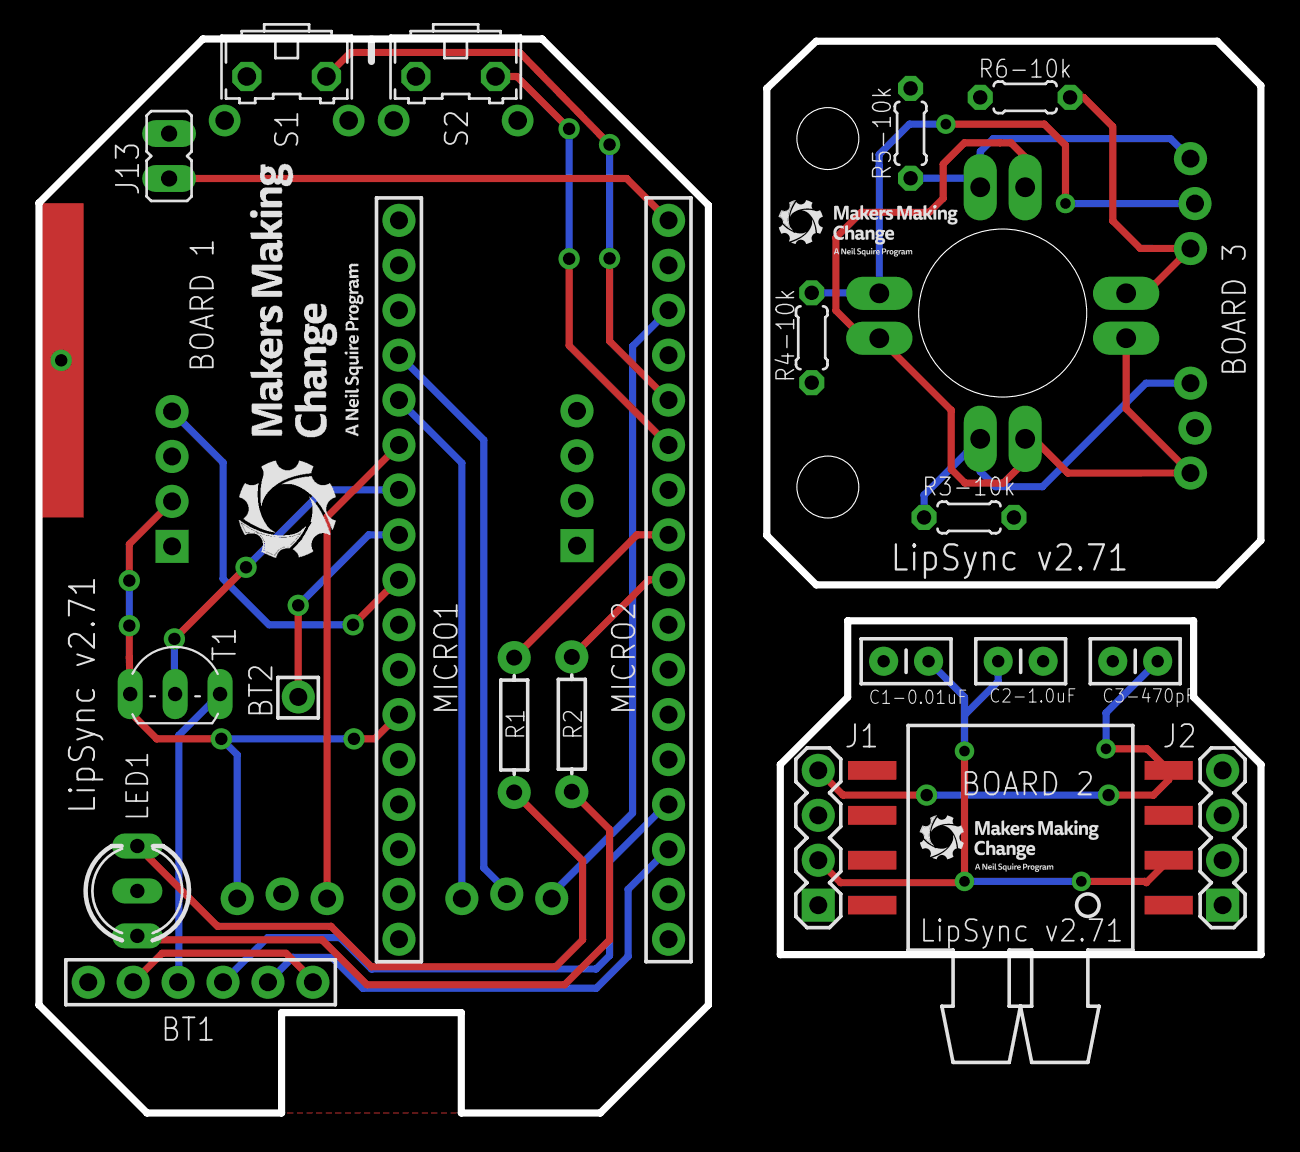
[picture p54: board LipSync_Interface_Board.brd from above]

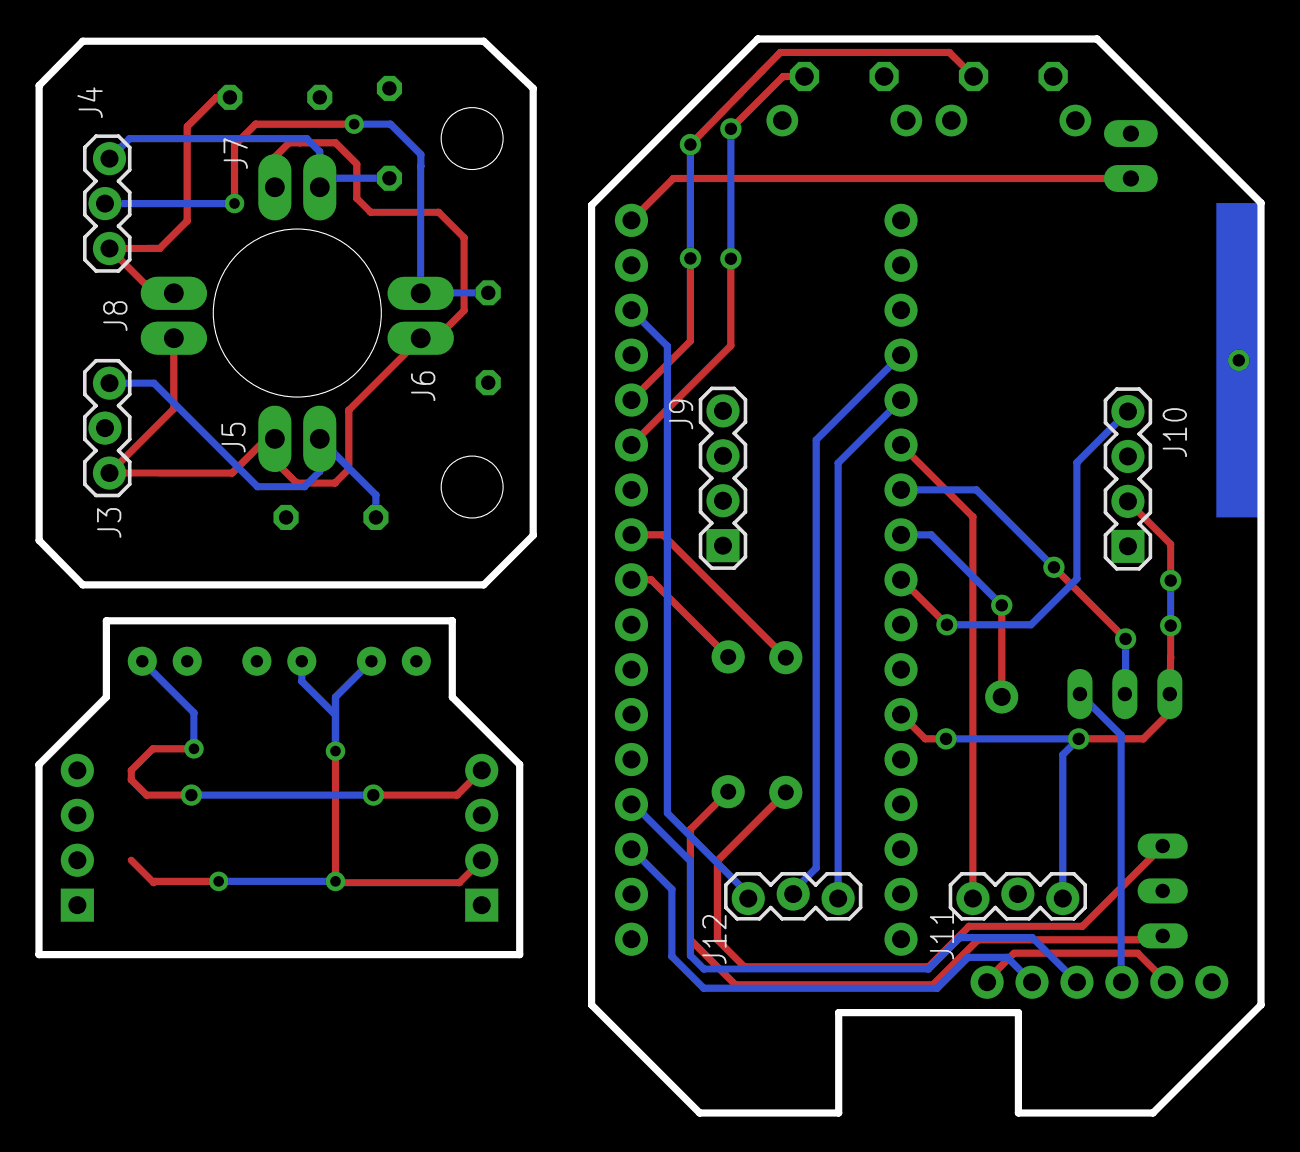
[picture p55: board LipSync_Interface_Board.brd from below]

Board: 2 copper layers, 69.1 x 60.7 mm, 31 parts (11 on the bottom side), 29 nets.
