makersmakingchange/LipSync-Wireless/(commit log)

2019-09-17 Added LipSync Wireless files
    [LipSync_Button.STL, LipSync_Front_Housing.STL, LipSync_Interface_Board.brd, LipSync_Interface_Board.sch, LipSync_Joystick_Base.STL, LipSync_Joystick_Front.STL, LipSync_Joystick_Rocker.STL, LipSync_Joystick_Stand.STL]
2019-09-20 Added the updated LipSync Manual, LipSync Wireless User Guide, LipSync Wireless Startup Guide, and LipSync Wireless BOM File.
    [LipSync_Wireless_BOM.csv, LipSync_Wireless_BOM.xlsx]
2019-09-20 Added the updated LipSync Manual, LipSync User Guide, LipSync Startup Guide, and LipSync BOM File.
2019-10-01 Add files via upload
    - The shell is slightly longer and the rear portion is slightly wider to accommodate a greater range of USB cables. The cut-out near the mounting hole is also larger and longer to prevent the threaded insert from damaging the cable, and allowing thicker cables to pass freely.
    - A recess has been added to the bottom to provide a less conspicuous location to apply any labelling.
    - The rear portion of the shell is larger and has greater surface area which should help mitigate any bed adhesion issues.
    - The cylindrical portions that house the springs have been lengthened and a catch was added that should retain the springs once they are pressed in. These changes should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
    [LipSync_Button.STL]
2019-10-01 Added PCB files Version 2.71 with updated MMC Logo.
    [LipSync_Interface_Board.brd, LipSync_Interface_Board.sch]
2019-10-01 Updated PCB version number in readme file.
2019-10-29 Added the updated LipSync Wireless Manual, LipSync Wireless User Guide, LipSync Wireless Startup Guide, and LipSync Wireless BOM File.
2020-03-09 Added the updated LipSync Manual, LipSync Wireless User Guide, LipSync Wireless Setup Guide, and LipSync BOM File.
2020-04-15 Added PCB board gerber files.
    [LipSync_Interface_Board.brd, LipSync_Interface_Board.sch, LipSync_Joystick_Board.brd, LipSync_Joystick_Board.sch, LipSync_Main_Board.brd, LipSync_Main_Board.sch, LipSync_Pressure_Board.brd, LipSync_Pressure_Board.sch]
2020-04-15 Updated readme file
    Added the links to PCB board gerber files.
2020-05-08 Added the PCB Fabrication Manual
2020-07-07 Fixed communication mode bug.
    [LipSync_Wireless_Firmware.ino]
2020-08-10 Corrected changeTolerance variable type
    [LipSync_Wireless_Firmware.ino]
2020-08-10 Added change tolerance for each FSR
    [LipSync_Wireless_Firmware.ino]
2020-11-25 Resolved EEPROM Debug and raw Mode status bug.
    [LipSync_Wireless_Firmware.ino]
2021-08-21 Mouse and Wireless Merge stage 1
2021-09-22 Added comments and fixed bluetooth APIs
    [LipSync_Wireless_Firmware.ino]
2021-10-05 Fixed auto connect bug
    [LipSync_Wireless_Firmware.ino]
2022-06-01 Resolved sip and puff bug
    readPressure function updated
    [LipSync_Wireless_Firmware.ino]
2022-06-01 Added back the software pullup for wireless config oin
2022-06-01 Added the software pullup for mode config pin
2022-06-04 Updating readme and move documents under Documentation directory
    [LipSync_Wireless_BOM.csv, LipSync_Wireless_BOM.xlsx]
2022-06-09 Removed STL files
    [LipSync_Button.STL, LipSync_Front_Housing.STL, LipSync_Joystick_Base.STL, LipSync_Joystick_Front.STL, LipSync_Joystick_Rocker.STL, LipSync_Joystick_Stand.STL, LipSync_Rear_Housing.STL, LipSync_Rear_Housing.stl]
2022-06-09 Added back stl files
    [LipSync_Button.stl, LipSync_Front_Housing.STL, LipSync_Joystick_Base.STL, LipSync_Joystick_Front.STL, LipSync_Joystick_Jig.STL, LipSync_Joystick_Rocker.STL, LipSync_Rear_Housing.STL]
2022-06-16 Updated Assembly Guide Document name
2022-06-17 Fixed command mode bug
    [LipSync_Wireless_Firmware.ino]
2022-06-28 Updated Documents
    [LipSync_Wireless_BOM.csv, LipSync_Wireless_BOM.xlsx]
2022-07-18 Updated Rear Housing STL to avoid merge conflict
    [LipSync_Rear_Housing.stl]
2022-07-18 Updated PCB Schematic link
